RockingRidz/LAUNCHPAD/bom.csv

item | quantity | unit_cost_INR | line_cost_INR | price_status | purchase_link | technical_source | notes | checked_date
Pi Zero 2 W | 1 | 2079 | 2079.0 | observed category listing; verify stock/GST | https://robu.in/product-category/raspberry-pi-zero/ | https://www.raspberrypi.com/products/raspberry-pi-zero-2-w/ | Board only; supplier alternatives can be much more expensive | 2026-11-07
Waveshare SKU16446 LCD ST7789 revision | 1 | 1475 | 1475.0 | observed price incl GST; seller lists 2 stock; controller revision unconfirmed | https://hubtronics.in/display-devices/lcds/other-lcds/2.8inch-resistive-touch-lcd | https://www.waveshare.com/wiki/2.8inch_Resistive_Touch_LCD | Confirm ST7789 stock; page advertises older HX8347D specifications | 2026-11-08
microSD 16GB or larger | 1 | 561 | 561.0 | observed aggregator in-stock starting price; confirm seller | https://findmychips.com/c/development-boards/memory-cards-storage-board-accessories/microsd-sd-memory-cards | https://www.raspberrypi.com/documentation/computers/getting-started.html | Flash fresh Raspberry Pi OS; old NOOBS image not used | 2026-11-07
Existing 12V battery and LM2596 buck converter | 1 | 0 | 0 | owned; user reports existing hardware |  | https://www.ti.com/product/LM2596 | External battery; verify 5V output and load capability before Pi connection; no battery enclosure or charger designed | 2026-11-08
5V active buzzer <=20mA | 0 | 30 | 0 | optional; omitted in minimum-cost submission | https://robu.in/product/5v-active-electromagnetic-buzzer-pack-of-5/ | https://robu.in/product/5v-active-electromagnetic-buzzer-pack-of-5/ | Use low-current part; change driver if purchased buzzer exceeds 20mA; add quantity 1 if fitting buzzer circuit | 2026-11-08
2N3904 TO-92 NPN | 0 | 5 | 0 | optional; omitted in minimum-cost submission | https://robu.in/?s=2N3904&post_type=product | https://robu.in/wp-content/uploads/2024/03/2861475.pdf | Verify emitter base collector pinout; add quantity 1 if fitting buzzer circuit | 2026-11-08
1N4148 diode | 0 | 3 | 0 | optional; omitted in minimum-cost submission | https://robu.in/?s=1N4148&post_type=product | https://www.onsemi.com/pdf/datasheet/1n4148-d.pdf | Cathode to 5V; add quantity 1 if fitting buzzer circuit | 2026-11-08
1k resistor 0.25W | 0 | 2 | 0 | optional; omitted in minimum-cost submission | https://robu.in/?s=1k+resistor&post_type=product | pcb/LAUNCHPAD.kicad_sch | Base current limit; add quantity 1 if fitting buzzer circuit | 2026-11-08
100k resistor 0.25W | 0 | 2 | 0 | optional; omitted in minimum-cost submission | https://robu.in/?s=100k+resistor&post_type=product | pcb/LAUNCHPAD.kicad_sch | Base-emitter pull-down; add quantity 1 if fitting buzzer circuit | 2026-11-08
2x20 male GPIO header 2.54mm | 1 | 20 | 20.0 | estimate; quote required | https://robu.in/?s=2x20+header&post_type=product | https://www.raspberrypi.com/documentation/computers/raspberry-pi.html | Soldering needed unless Pi supplied with header | 2026-11-07
Mini breadboard or perfboard | 0 | 60 | 0 | optional; omitted in minimum-cost submission | https://robu.in/?s=mini+breadboard&post_type=product | production/BUILD.md | Perfboard is more secure for final wired build; add quantity 1 if fitting buzzer circuit | 2026-11-08
Female jumper wire set | 1 | 80 | 80.0 | estimate; quote required | https://robu.in/?s=female+jumper&post_type=product | pcb/wiring.csv | Check connector pitch against display | 2026-11-07
M2.5 nylon screw/spacer assortment | 1 | 100 | 100.0 | estimate; quote required | https://robu.in/?s=M2.5+spacer&post_type=product | production/BUILD.md | At least four 4mm spacers; choose screw lengths after stack check | 2026-11-07
M3x10 self-tapping screw | 8 | 3 | 24.0 | estimate; quote required | https://robu.in/?s=M3+screw&post_type=product | production/BUILD.md | Four rear-cover screws and four LCD-retainer screws; verify printed pilots | 2026-11-07
Foam tape and insulating tape | 1 | 50 | 50.0 | estimate; local source | https://robu.in/?s=foam+tape&post_type=product | production/BUILD.md | PCB edge retention and insulation | 2026-11-07
Robu print service: complete six-part case | 1 | 951 | 951 | observed instant quote incl GST; subject to manufacturing review | https://robu.in/product/3d-printing-service1/ | production/PRINT-QUOTE.md | 0.2mm standard black PLA 20% infill; coupons excluded; delivery allowance separate | 2026-11-08
Delivery allowance | 1 | 250 | 250.0 | estimate; checkout determines actual | https://hubtronics.in/ | production/BUILD.md | Multiple suppliers may exceed allowance | 2026-11-07
Micro-USB power lead / buck output connector allowance | 1 | 50 | 50 | estimate; may be reused |  | production/BUILD.md | Connect regulated 5V to Pi power micro-USB; never connect 12V directly | 2026-11-08
