RockingRidz/LAUNCHPAD/cad/LAUNCHPAD-assembly.step

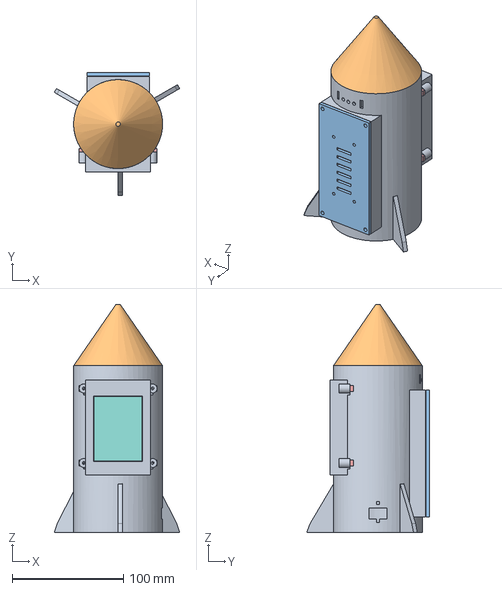
[picture p4: CAD file, 2026-11-07]
cad/LAUNCHPAD-assembly.step
112.9 x 110.2 x 205.0 mm
