RockingRidz/LAUNCHPAD/cad/fit-checks/FitChecks.FCStd

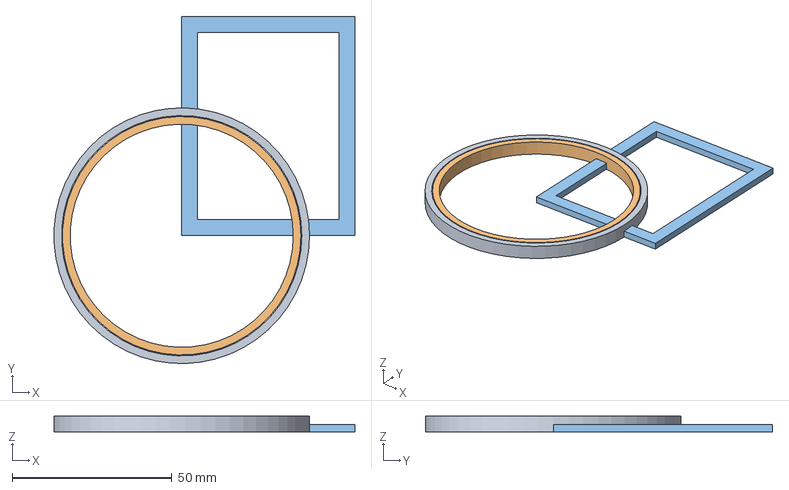
[picture p5: CAD file, 2026-11-08]
cad/fit-checks/FitChecks.FCStd
94.1 x 108.6 x 5.00 mm
NoseFemaleCoupon
NoseMaleCoupon
ScreenApertureCoupon
