RockingRidz/LAUNCHPAD/production/LAUNCHPAD-CasePrintSet.stl

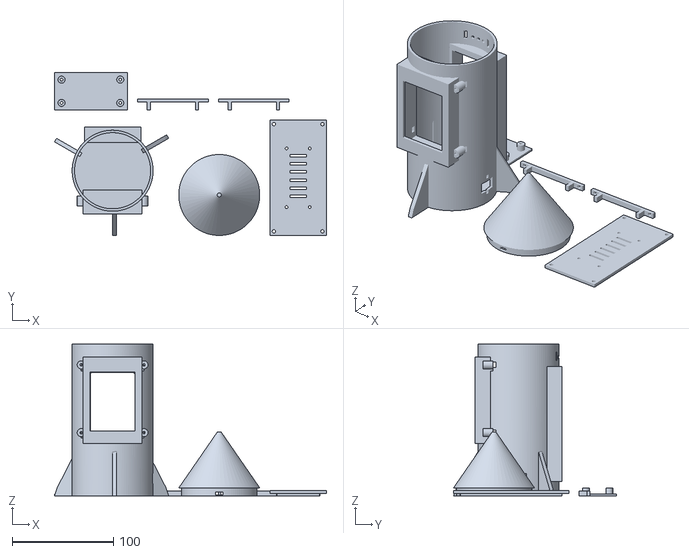
[picture p6: CAD file, 2026-11-08]
production/LAUNCHPAD-CasePrintSet.stl
268.8 x 161.0 x 150.0
