RockingRidz/LAUNCHPAD/cad/fit-checks/NoseMaleCoupon.step

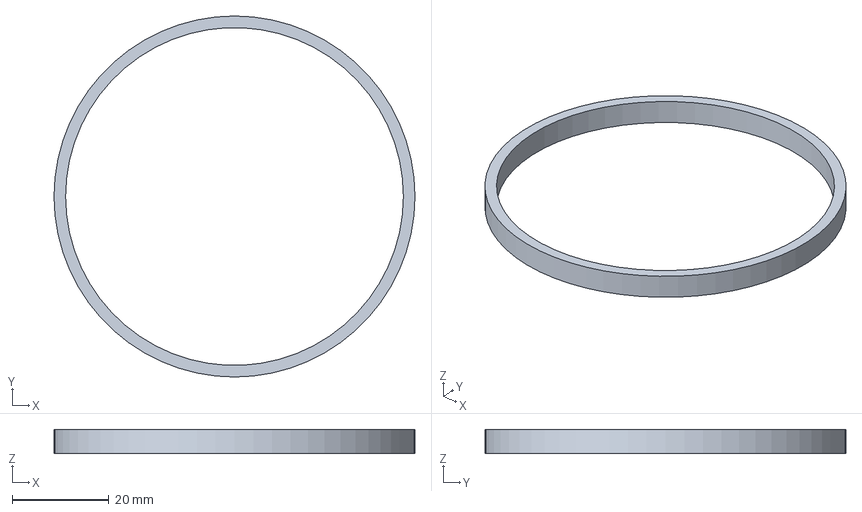
[picture p7: CAD file, 2026-11-08]
cad/fit-checks/NoseMaleCoupon.step
74.6 x 74.6 x 5.00 mm
