RockingRidz/LAUNCHPAD/cad/RocketBody.step

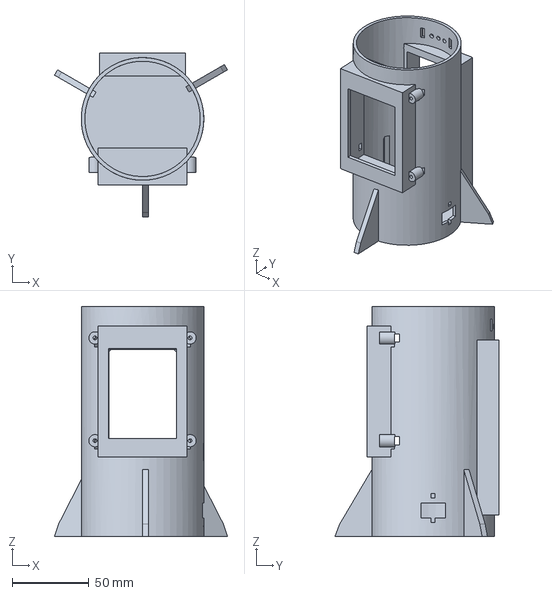
[picture p8: CAD file, 2026-11-07]
cad/RocketBody.step
112.9 x 107.0 x 150.0 mm
