RockingRidz/LAUNCHPAD/cad/fit-checks/ScreenApertureCoupon.step

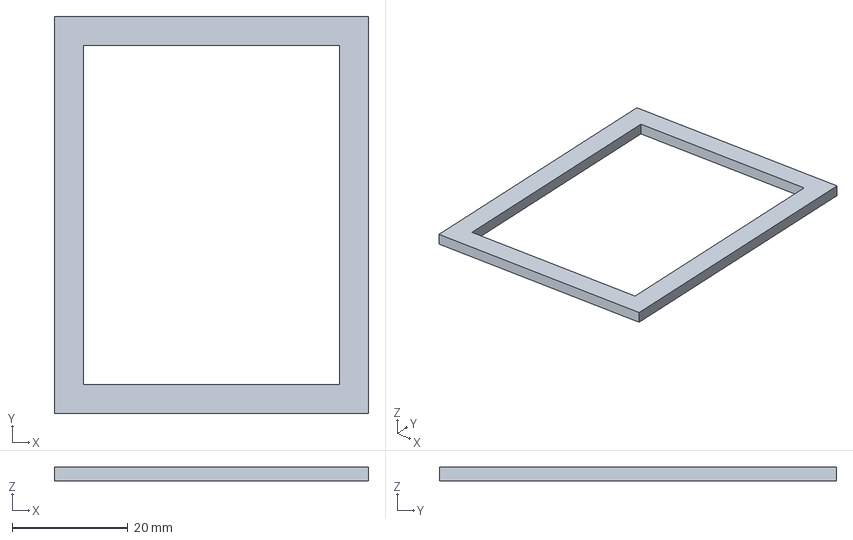
[picture p9: CAD file, 2026-11-08]
cad/fit-checks/ScreenApertureCoupon.step
54.2 x 68.6 x 2.40 mm
