RockingRidz/LAUNCHPAD/cad/LCDRetainerLower.step

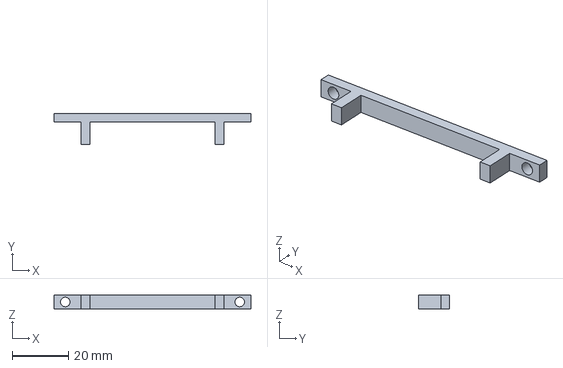
[picture p10: CAD file, 2026-11-07]
cad/LCDRetainerLower.step
70.0 x 11.0 x 5.00 mm
