RockingRidz/LAUNCHPAD/cad/fit-checks/NoseFemaleCoupon.step

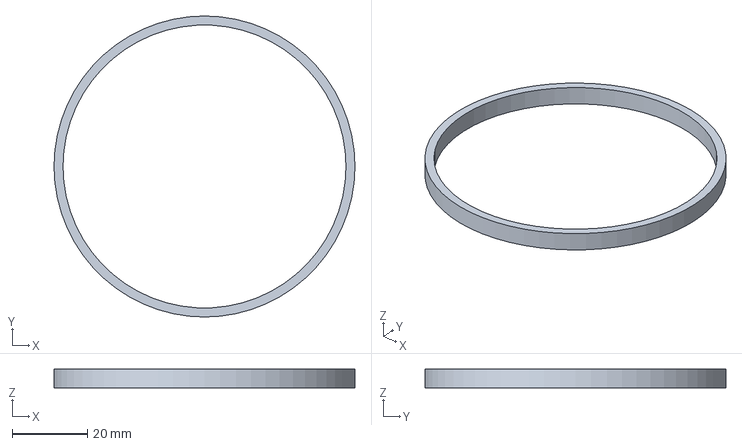
[picture p11: CAD file, 2026-11-08]
cad/fit-checks/NoseFemaleCoupon.step
80.0 x 80.0 x 5.00 mm
