RockingRidz/LAUNCHPAD/cad/PiCarrier.step

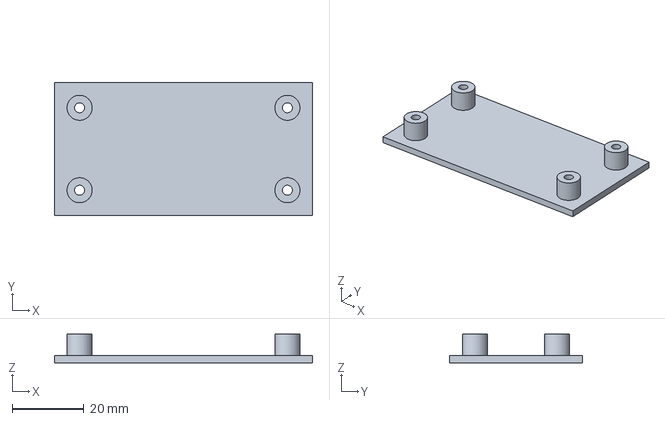
[picture p12: CAD file, 2026-11-07]
cad/PiCarrier.step
72.0 x 37.0 x 8.00 mm
