RockingRidz/LAUNCHPAD/cad/NoseCone.step

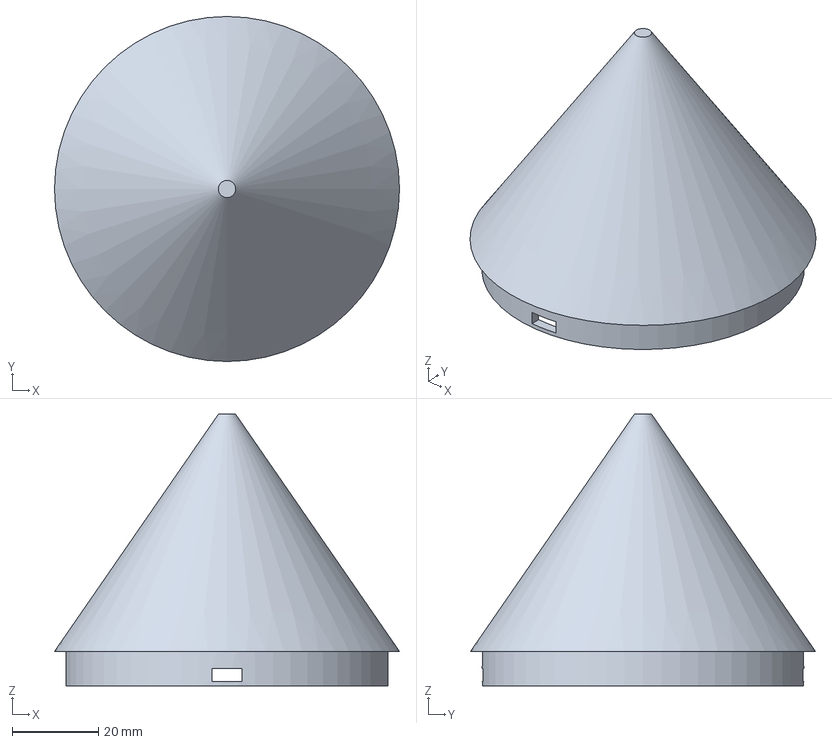
[picture p13: CAD file, 2026-11-07]
cad/NoseCone.step
80.0 x 80.0 x 63.0 mm
