RockingRidz/LAUNCHPAD/cad/RearCover.step

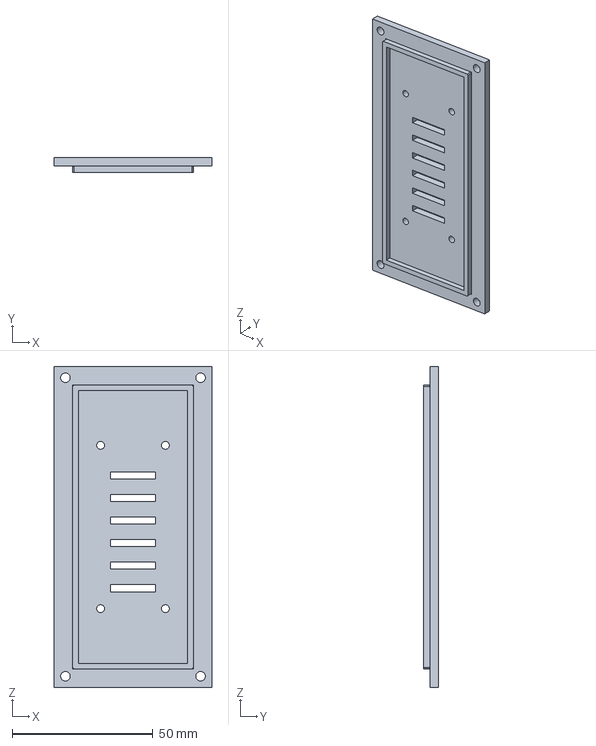
[picture p14: CAD file, 2026-11-07]
cad/RearCover.step
56.0 x 5.20 x 114.0 mm
