RockingRidz/LAUNCHPAD/(list of files, cad)

Other CAD files:
cad/LCDRetainerUpper.step
cad/LAUNCHPAD.FCStd
cad/LCDRetainerLower.stl
cad/LCDRetainerUpper.stl
cad/NoseCone.stl
cad/PiCarrier.stl
cad/RearCover.stl
cad/RocketBody.stl
cad/fit-checks/NoseFemaleCoupon.stl
cad/fit-checks/NoseMaleCoupon.stl
cad/fit-checks/ScreenApertureCoupon.stl
