RockingRidz/LAUNCHPAD/production/PRINT-QUOTE.md

# Robu printing estimate — 8 November 2026

Observed instant quotation: **Rs951 including GST** for one six-part case set, black PLA, 0.2mm standard quality, 20% infill. No order was placed. Shipping is not included in this quote; the BOM separately reserves Rs250 for delivery across suppliers.

Uploaded file: LAUNCHPAD-CasePrintSet.stl. It contains six disconnected, separated meshes in millimetres: RocketBody, NoseCone, RearCover, PiCarrier, LCDRetainerLower and LCDRetainerUpper. The rear cover is rotated onto its broad face; other exported orientations are retained. It is a quote layout, not an assembled rocket or a validated production print plate. Manufacturer review, supports, orientation and whether multipart files are accepted for fulfilment can change the price. Fit coupons are excluded.

Robu reported a 16.10 x 26.88 x 15.00 cm envelope, material volume 181.10 cm3 and print time 10:31:14. The body alone was quoted at Rs683. These are service estimates, not physical measurements.

Service: https://robu.in/product/3d-printing-service1/

The original six STL files in /cad remain the authoritative individual parts. The quote set is in /production for reproducing the estimate. Screenshot evidence is supplied separately in the local delivery folder; it includes browser chrome and is not published to the repository.
