RockingRidz/LAUNCHPAD/pcb/wiring.csv

Signal | Pi_physical_pin | Pi_BCM_or_rail | Destination
5V | 2 | 5V | LCD1.1
GND | 6 | GND | LCD1.2
MISO | 21 | GPIO9 | LCD1.3
MOSI | 19 | GPIO10 | LCD1.4
SCLK | 23 | GPIO11 | LCD1.5
LCD_CS | 24 | GPIO8 | LCD1.6
LCD_DC | 22 | GPIO25 | LCD1.7
LCD_RST | 13 | GPIO27 | LCD1.8
LCD_BL | 12 | GPIO18 | LCD1.9
TP_CS | 26 | GPIO7 | LCD1.10
TP_IRQ | 18 | GPIO24 | LCD1.11
BUZZER_CONTROL | 11 | GPIO17 | R1 1k -> Q1 base
BUZZER_POWER | 4 | 5V | BZ1+ and D1 cathode
BUZZER_GROUND | 9 | GND | Q1 emitter and R2 lower end
