RockingRidz/LAUNCHPAD/pcb/LAUNCHPAD.pdf

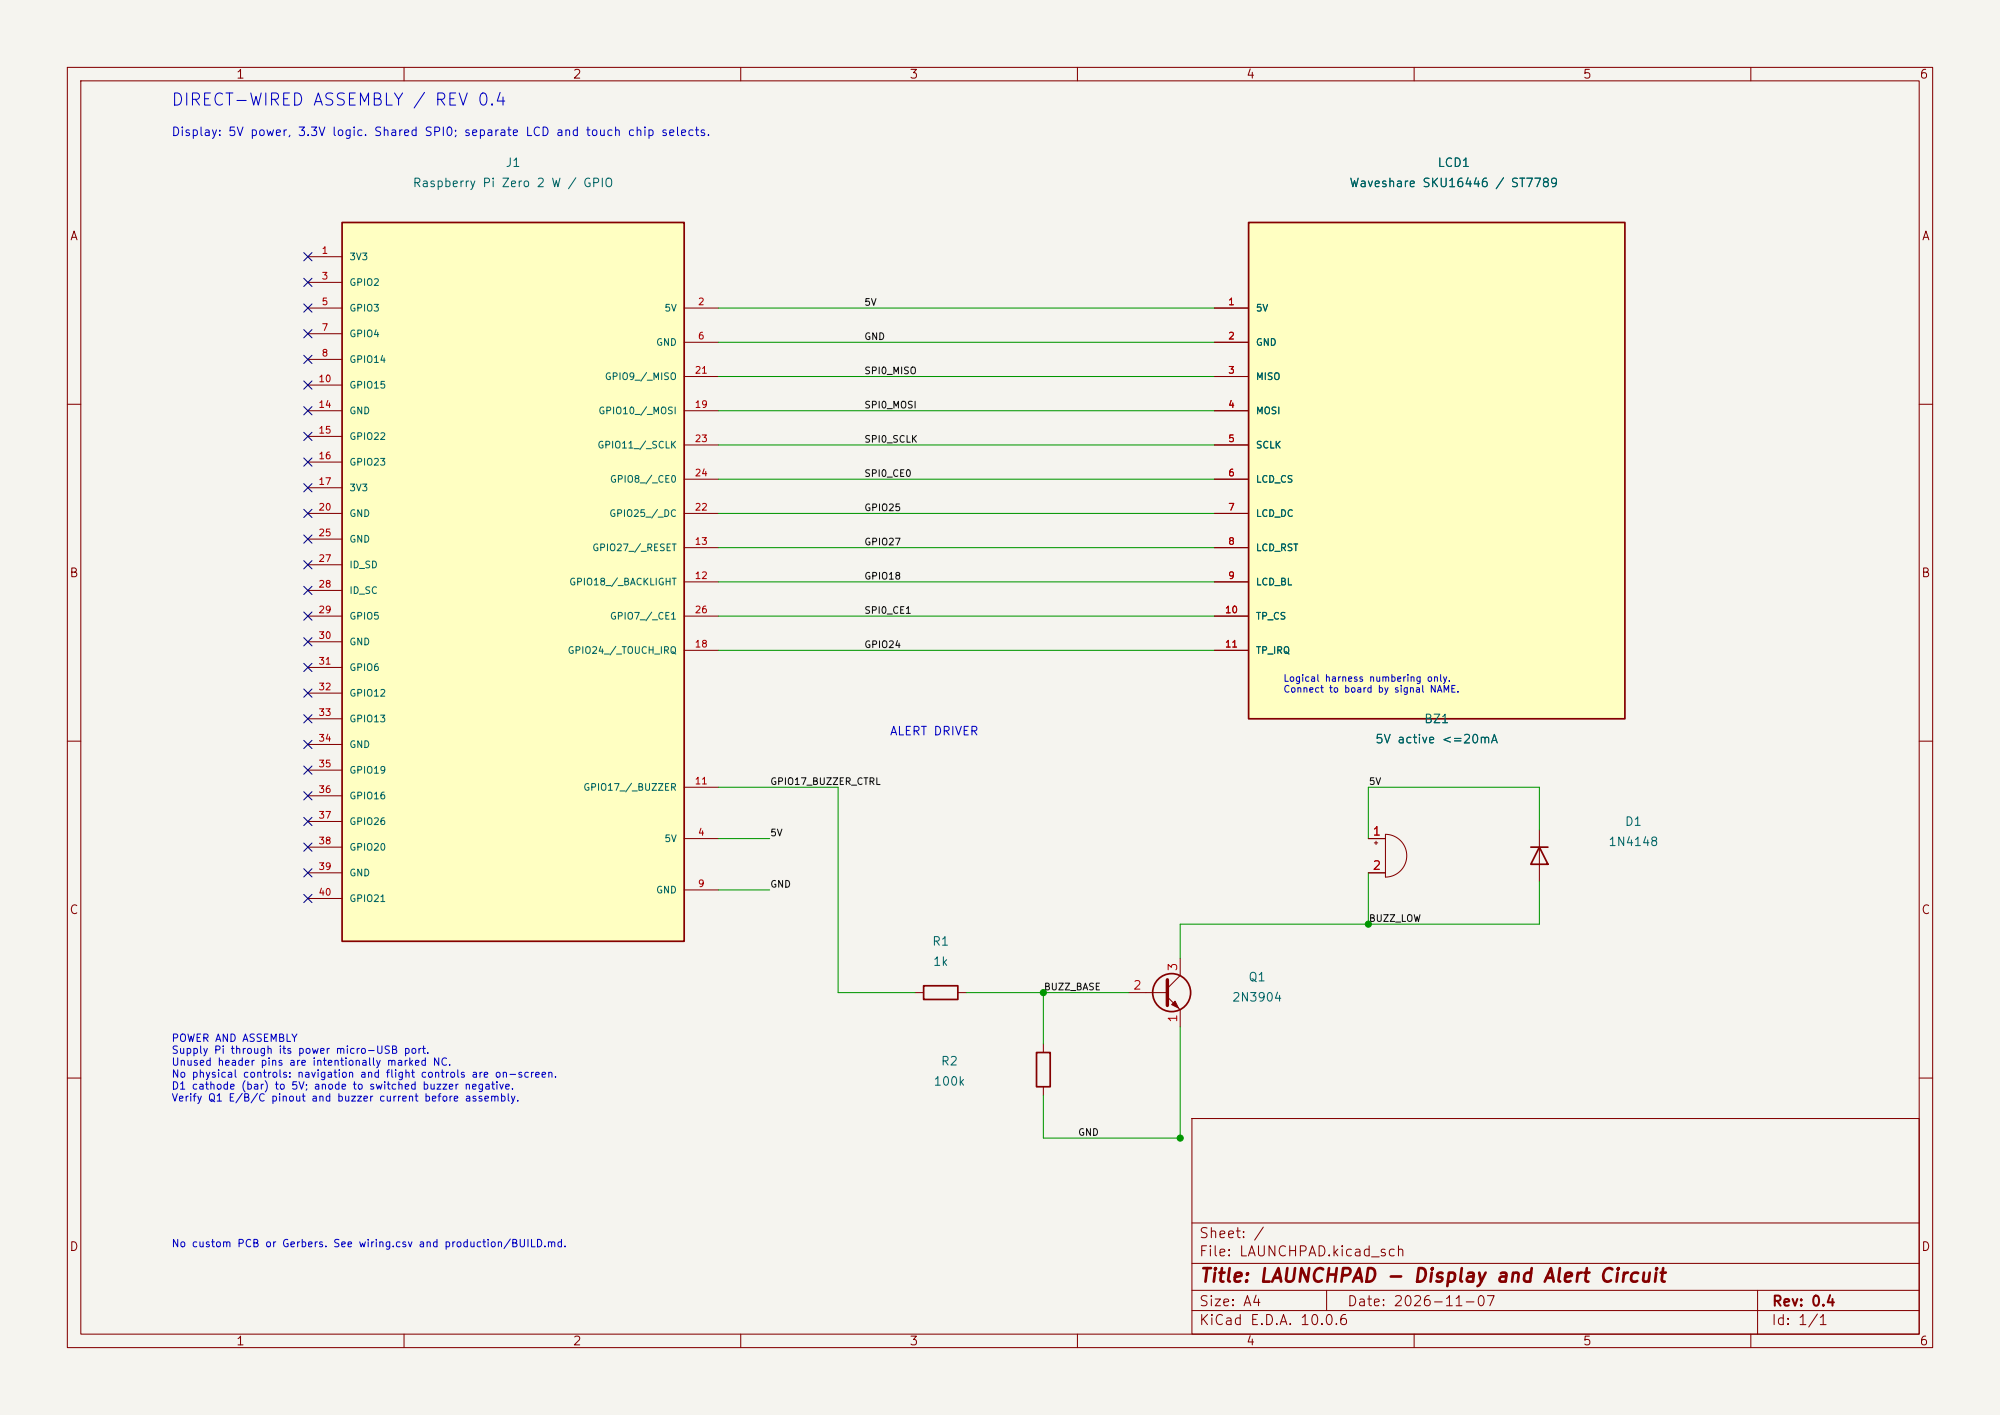
[picture p15: page 1]

DIRECT-WIRED ASSEMBLY / REV 0.4

Display: 5V power, 3.3V logic. Shared SPI0; separate LCD and touch chip selects.

J1 Raspberry Pi Zero 2 W / GPIO

Logical harness numbering only. Connect to board by signal NAME.

POWER AND ASSEMBLY Supply Pi through its power micro-USB port. Unused header pins are intentionally marked NC. No physical controls: navigation and flight controls are on-screen. D1 cathode (bar) to 5V; anode to switched buzzer negative.

Verify Q1 E/B/C pinout and buzzer current before assembly. No custom PCB or Gerbers. See wiring.csv and production/BUILD.md.

Sheet: /
File: LAUNCHPAD.kicad_sch
Title: LAUNCHPAD - Display and Alert Circuit

Size: A4 | Rev: 0.4
KiCad E.D.A. 10.0.6 | Id: 1/1
