RockingRidz/LAUNCHPAD/pcb/LAUNCHPAD.kicad_sch

## KiCad design pcb/LAUNCHPAD.kicad_sch (2026-11-07)

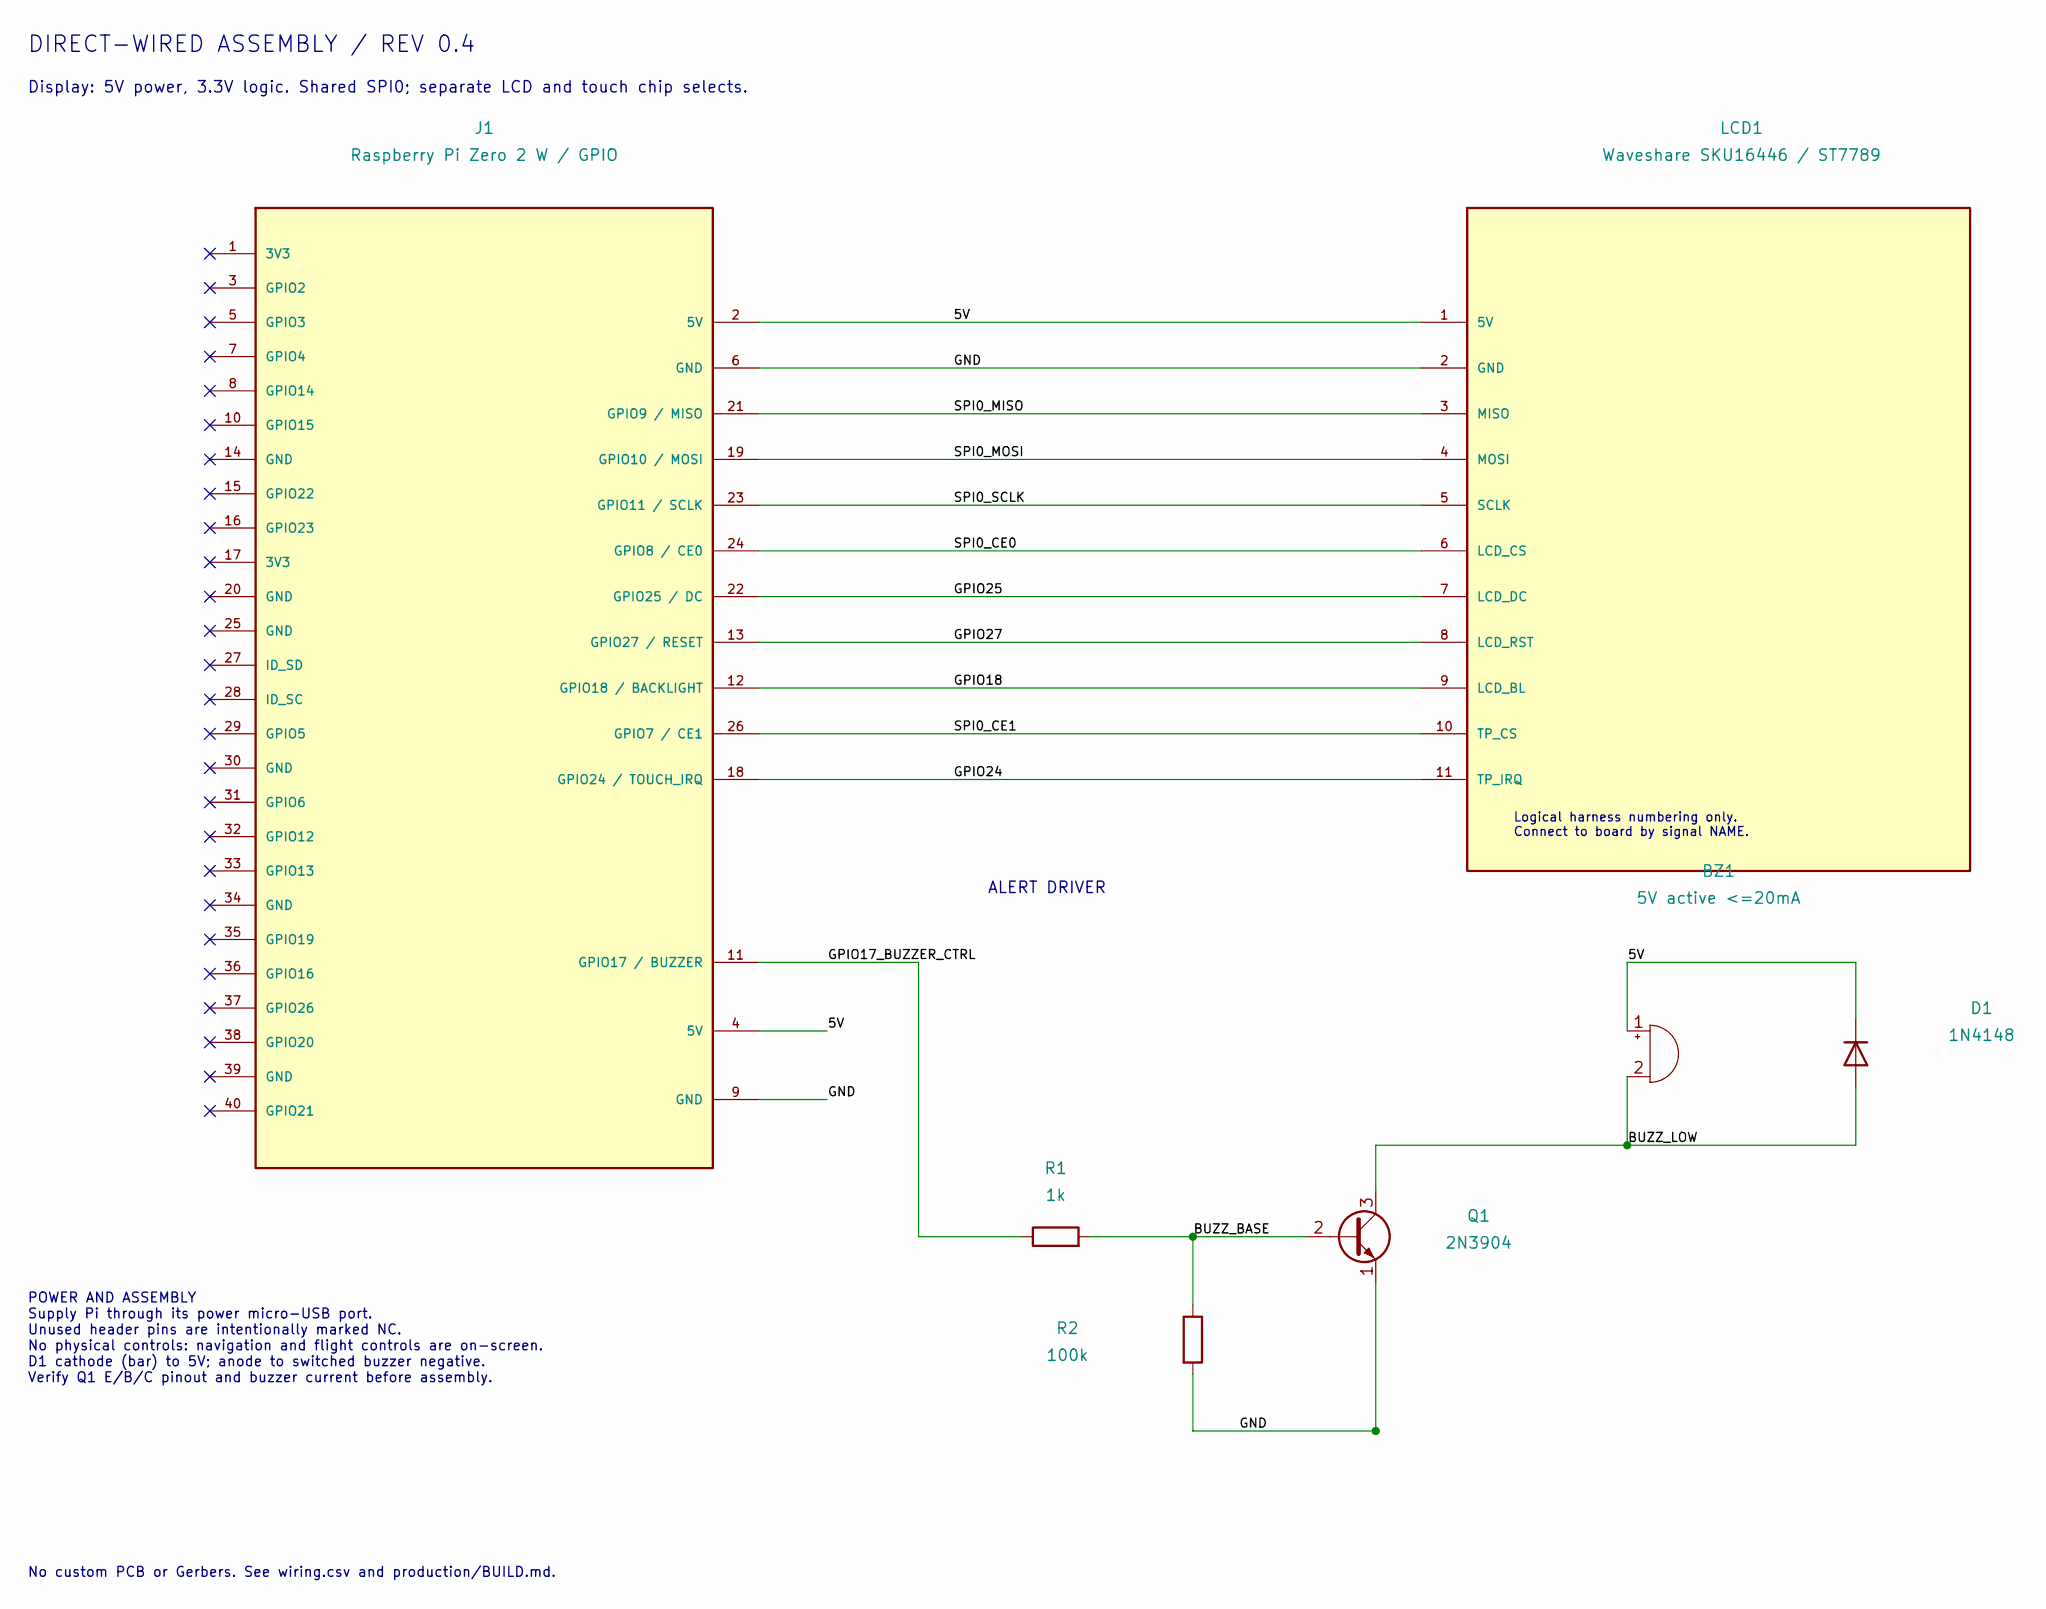
[picture p16: schematic LAUNCHPAD.kicad_sch]

Parts:
BZ1: 5V active <=20mA
D1: 1N4148
J1: Raspberry Pi Zero 2 W / GPIO
LCD1: Waveshare SKU16446 / ST7789
Q1: 2N3904
R1: 1k
R2: 100k

Connections:
5V: BZ1.1 (+), D1.1 (K), J1.2 (5V), J1.4 (5V), LCD1.1 (5V)
BUZZ_BASE: Q1.2 (B), R1.2, R2.1
BUZZ_LOW: BZ1.2 (-), D1.2 (A), Q1.3 (C)
GND: J1.6 (GND), J1.9 (GND), LCD1.2 (GND), Q1.1 (E), R2.2
GPIO17_BUZZER_CTRL: J1.11 (GPIO17 / BUZZER), R1.1
GPIO18: J1.12 (GPIO18 / BACKLIGHT), LCD1.9 (LCD_BL)
GPIO24: J1.18 (GPIO24 / TOUCH_IRQ), LCD1.11 (TP_IRQ)
GPIO25: J1.22 (GPIO25 / DC), LCD1.7 (LCD_DC)
GPIO27: J1.13 (GPIO27 / RESET), LCD1.8 (LCD_RST)
SPI0_CE0: J1.24 (GPIO8 / CE0), LCD1.6 (LCD_CS)
SPI0_CE1: J1.26 (GPIO7 / CE1), LCD1.10 (TP_CS)
SPI0_MISO: J1.21 (GPIO9 / MISO), LCD1.3 (MISO)
SPI0_MOSI: J1.19 (GPIO10 / MOSI), LCD1.4 (MOSI)
SPI0_SCLK: J1.23 (GPIO11 / SCLK), LCD1.5 (SCLK)

Notes on the sheet:
DIRECT-WIRED ASSEMBLY / REV 0.4
Display: 5V power, 3.3V logic. Shared SPI0; separate LCD and touch chip selects.
Logical harness numbering only. Connect to board by signal NAME.
POWER AND ASSEMBLY Supply Pi through its power micro-USB port. Unused header pins are intentionally marked NC. No physical controls: navigation and flight controls are on-screen. D1 cathode (bar) to 5V; anode to switched buzzer negative. Verify Q1 E/B/C pinout and buzzer current before assembly.
ALERT DRIVER
No custom PCB or Gerbers. See wiring.csv and production/BUILD.md.
