RockingRidz/LAUNCHPAD/(commit log)

2026-11-07 Add LAUNCHPAD rocket enclosure, connected schematic and five-mode firmware
    [LAUNCHPAD-assembly.step, LAUNCHPAD.FCStd, LAUNCHPAD.kicad_sch, LCDRetainerLower.step, LCDRetainerLower.stl, LCDRetainerUpper.step, LCDRetainerUpper.stl, NoseCone.step]
2026-11-08 Enhance pass planning, flight controls and print-fit checks
    [FitChecks.FCStd, NoseFemaleCoupon.step, NoseFemaleCoupon.stl, NoseMaleCoupon.step, NoseMaleCoupon.stl, ScreenApertureCoupon.step, ScreenApertureCoupon.stl]
2026-11-08 Finalize submission with owned power, optional alerts and sourced print budget
    [LAUNCHPAD-CasePrintSet.stl, bom.csv]
